xuanjihub/fpga-project-submission/05_PCB最终采纳/A01.2模块互连载板/reports/pin-map.csv

page | designator | pin | x | y | nc | net
01-FPGA-and-Power.esch2 | C1 | 1 | 760 | 480 | false | PWR_3V3
01-FPGA-and-Power.esch2 | C1 | 2 | 800 | 480 | false | GND
01-FPGA-and-Power.esch2 | C2 | 1 | 960 | 480 | false | PWR_3V3
01-FPGA-and-Power.esch2 | C2 | 2 | 1000 | 480 | false | GND
02-Touch-and-FSR.esch2 | C3 | 1 | 880 | 420 | false | PWR_3V3
02-Touch-and-FSR.esch2 | C3 | 2 | 920 | 420 | false | GND
03-Panel-and-OLED.esch2 | C4 | 1 | 780 | 355 | false | PWR_3V3
03-Panel-and-OLED.esch2 | C4 | 2 | 820 | 355 | false | GND
04-PCM-Audio.esch2 | C5 | 1 | 280 | 430 | false | PWR_5V
04-PCM-Audio.esch2 | C5 | 2 | 320 | 430 | false | GND
04-PCM-Audio.esch2 | C6 | 1 | 630 | 430 | false | PWR_5V
04-PCM-Audio.esch2 | C6 | 2 | 670 | 430 | false | GND
01-FPGA-and-Power.esch2 | J1 | 1 | 330 | 655 | true
01-FPGA-and-Power.esch2 | J1 | 2 | 390 | 655 | true
01-FPGA-and-Power.esch2 | J1 | 3 | 330 | 645 | false | SENS_SCL
01-FPGA-and-Power.esch2 | J1 | 4 | 390 | 645 | false | SENS_SDA
01-FPGA-and-Power.esch2 | J1 | 5 | 330 | 635 | false | PCM_BCK
01-FPGA-and-Power.esch2 | J1 | 6 | 390 | 635 | false | PCM_LRCK
01-FPGA-and-Power.esch2 | J1 | 7 | 330 | 625 | false | PCM_DIN
01-FPGA-and-Power.esch2 | J1 | 8 | 390 | 625 | true
01-FPGA-and-Power.esch2 | J1 | 9 | 330 | 615 | true
01-FPGA-and-Power.esch2 | J1 | 10 | 390 | 615 | true
01-FPGA-and-Power.esch2 | J1 | 11 | 330 | 605 | false | PWR_5V
01-FPGA-and-Power.esch2 | J1 | 12 | 390 | 605 | false | GND
01-FPGA-and-Power.esch2 | J1 | 13 | 330 | 595 | false | OLED_SCL
01-FPGA-and-Power.esch2 | J1 | 14 | 390 | 595 | false | OLED_SDA
01-FPGA-and-Power.esch2 | J1 | 15 | 330 | 585 | false | ENC0_A
01-FPGA-and-Power.esch2 | J1 | 16 | 390 | 585 | false | ENC0_B
01-FPGA-and-Power.esch2 | J1 | 17 | 330 | 575 | false | ENC1_A
01-FPGA-and-Power.esch2 | J1 | 18 | 390 | 575 | false | ENC1_B
01-FPGA-and-Power.esch2 | J1 | 19 | 330 | 565 | false | ENC2_A
01-FPGA-and-Power.esch2 | J1 | 20 | 390 | 565 | false | ENC2_B
01-FPGA-and-Power.esch2 | J1 | 21 | 330 | 555 | false | ENC3_A
01-FPGA-and-Power.esch2 | J1 | 22 | 390 | 555 | false | ENC3_B
01-FPGA-and-Power.esch2 | J1 | 23 | 330 | 545 | false | PANEL_K0
01-FPGA-and-Power.esch2 | J1 | 24 | 390 | 545 | false | PANEL_K1
01-FPGA-and-Power.esch2 | J1 | 25 | 330 | 535 | false | PANEL_K2
01-FPGA-and-Power.esch2 | J1 | 26 | 390 | 535 | false | PANEL_K3
01-FPGA-and-Power.esch2 | J1 | 27 | 330 | 525 | false | PANEL_K4
01-FPGA-and-Power.esch2 | J1 | 28 | 390 | 525 | false | PANEL_K5
01-FPGA-and-Power.esch2 | J1 | 29 | 330 | 515 | true
01-FPGA-and-Power.esch2 | J1 | 30 | 390 | 515 | true
01-FPGA-and-Power.esch2 | J1 | 31 | 330 | 505 | false | PANEL_K6
01-FPGA-and-Power.esch2 | J1 | 32 | 390 | 505 | false | PANEL_K7
01-FPGA-and-Power.esch2 | J1 | 33 | 330 | 495 | false | LASER_RX0
01-FPGA-and-Power.esch2 | J1 | 34 | 390 | 495 | false | LASER_RX1
01-FPGA-and-Power.esch2 | J1 | 35 | 330 | 485 | false | BLE_TX
01-FPGA-and-Power.esch2 | J1 | 36 | 390 | 485 | false | BLE_RX
01-FPGA-and-Power.esch2 | J1 | 37 | 330 | 475 | true
01-FPGA-and-Power.esch2 | J1 | 38 | 390 | 475 | true
01-FPGA-and-Power.esch2 | J1 | 39 | 330 | 465 | true
01-FPGA-and-Power.esch2 | J1 | 40 | 390 | 465 | true
01-FPGA-and-Power.esch2 | J2 | 1 | 830 | 655 | false | PWR_3V3
01-FPGA-and-Power.esch2 | J2 | 2 | 830 | 645 | false | GND
02-Touch-and-FSR.esch2 | J3 | 1 | 280 | 670 | false | GND
02-Touch-and-FSR.esch2 | J3 | 2 | 280 | 660 | false | SENS_SDA
02-Touch-and-FSR.esch2 | J3 | 3 | 280 | 650 | false | SENS_SCL
02-Touch-and-FSR.esch2 | J3 | 4 | 280 | 640 | true
02-Touch-and-FSR.esch2 | J3 | 5 | 280 | 630 | false | PWR_3V3
02-Touch-and-FSR.esch2 | J4 | 1 | 880 | 665 | false | PWR_3V3
02-Touch-and-FSR.esch2 | J4 | 2 | 880 | 655 | false | GND
02-Touch-and-FSR.esch2 | J4 | 3 | 880 | 645 | false | SENS_SCL
02-Touch-and-FSR.esch2 | J4 | 4 | 880 | 635 | false | SENS_SDA
02-Touch-and-FSR.esch2 | J4 | 5 | 880 | 625 | false | GND
02-Touch-and-FSR.esch2 | J4 | 6 | 880 | 615 | true
02-Touch-and-FSR.esch2 | J4 | 7 | 880 | 605 | false | GND
02-Touch-and-FSR.esch2 | J4 | 8 | 880 | 595 | false | FSR_A1
02-Touch-and-FSR.esch2 | J4 | 9 | 880 | 585 | true
02-Touch-and-FSR.esch2 | J4 | 10 | 880 | 575 | true
02-Touch-and-FSR.esch2 | J5 | 1 | 280 | 445 | false | PWR_3V3
02-Touch-and-FSR.esch2 | J5 | 2 | 280 | 435 | false | FSR_A1
03-Panel-and-OLED.esch2 | J6 | 1 | 260 | 670 | false | GND
03-Panel-and-OLED.esch2 | J6 | 2 | 260 | 660 | false | ENC0_A
03-Panel-and-OLED.esch2 | J6 | 3 | 260 | 650 | false | ENC0_B
03-Panel-and-OLED.esch2 | J6 | 4 | 260 | 640 | true
03-Panel-and-OLED.esch2 | J6 | 5 | 260 | 630 | false | PWR_3V3
03-Panel-and-OLED.esch2 | J7 | 1 | 620 | 670 | false | GND
03-Panel-and-OLED.esch2 | J7 | 2 | 620 | 660 | false | ENC1_A
03-Panel-and-OLED.esch2 | J7 | 3 | 620 | 650 | false | ENC1_B
03-Panel-and-OLED.esch2 | J7 | 4 | 620 | 640 | true
03-Panel-and-OLED.esch2 | J7 | 5 | 620 | 630 | false | PWR_3V3
03-Panel-and-OLED.esch2 | J8 | 1 | 260 | 470 | false | GND
03-Panel-and-OLED.esch2 | J8 | 2 | 260 | 460 | false | ENC2_A
03-Panel-and-OLED.esch2 | J8 | 3 | 260 | 450 | false | ENC2_B
03-Panel-and-OLED.esch2 | J8 | 4 | 260 | 440 | true
03-Panel-and-OLED.esch2 | J8 | 5 | 260 | 430 | false | PWR_3V3
03-Panel-and-OLED.esch2 | J9 | 1 | 620 | 470 | false | GND
03-Panel-and-OLED.esch2 | J9 | 2 | 620 | 460 | false | ENC3_A
03-Panel-and-OLED.esch2 | J9 | 3 | 620 | 450 | false | ENC3_B
03-Panel-and-OLED.esch2 | J9 | 4 | 620 | 440 | true
03-Panel-and-OLED.esch2 | J9 | 5 | 620 | 430 | false | PWR_3V3
03-Panel-and-OLED.esch2 | J10 | 1 | 1000 | 675 | false | PWR_3V3
03-Panel-and-OLED.esch2 | J10 | 2 | 1000 | 665 | false | GND
03-Panel-and-OLED.esch2 | J10 | 3 | 1000 | 655 | false | PANEL_K0
03-Panel-and-OLED.esch2 | J10 | 4 | 1000 | 645 | false | PANEL_K1
03-Panel-and-OLED.esch2 | J10 | 5 | 1000 | 635 | false | PANEL_K2
03-Panel-and-OLED.esch2 | J10 | 6 | 1000 | 625 | false | PANEL_K3
03-Panel-and-OLED.esch2 | J10 | 7 | 1000 | 615 | false | PANEL_K4
03-Panel-and-OLED.esch2 | J10 | 8 | 1000 | 605 | false | PANEL_K5
03-Panel-and-OLED.esch2 | J10 | 9 | 1000 | 595 | false | PANEL_K6
03-Panel-and-OLED.esch2 | J10 | 10 | 1000 | 585 | false | PANEL_K7
03-Panel-and-OLED.esch2 | J11 | 1 | 1000 | 455 | false | GND
03-Panel-and-OLED.esch2 | J11 | 2 | 1000 | 445 | false | PWR_3V3
03-Panel-and-OLED.esch2 | J11 | 3 | 1000 | 435 | false | OLED_SCL
03-Panel-and-OLED.esch2 | J11 | 4 | 1000 | 425 | false | OLED_SDA
04-PCM-Audio.esch2 | J12 | 1 | 280 | 675 | false | GND
04-PCM-Audio.esch2 | J12 | 2 | 280 | 665 | false | PCM_BCK
04-PCM-Audio.esch2 | J12 | 3 | 280 | 655 | false | PCM_DIN
04-PCM-Audio.esch2 | J12 | 4 | 280 | 645 | false | PCM_LRCK
04-PCM-Audio.esch2 | J12 | 5 | 280 | 635 | false | GND
04-PCM-Audio.esch2 | J12 | 6 | 280 | 625 | false | PWR_5V
04-PCM-Audio.esch2 | J13 | 1 | 880 | 680 | false | PCM_A3V3
04-PCM-Audio.esch2 | J13 | 2 | 880 | 670 | false | GND
04-PCM-Audio.esch2 | J13 | 3 | 880 | 660 | false | PCM_A3V3
04-PCM-Audio.esch2 | J13 | 4 | 880 | 650 | false | GND
04-PCM-Audio.esch2 | J13 | 5 | 880 | 640 | false | PCM_A3V3
04-PCM-Audio.esch2 | J13 | 6 | 880 | 630 | true
04-PCM-Audio.esch2 | J13 | 7 | 880 | 620 | true
04-PCM-Audio.esch2 | J13 | 8 | 880 | 610 | true
04-PCM-Audio.esch2 | J13 | 9 | 880 | 600 | true
05-Expansion-and-Notes.esch2 | J14 | 1 | 280 | 665 | false | PWR_3V3
05-Expansion-and-Notes.esch2 | J14 | 2 | 280 | 655 | false | GND
05-Expansion-and-Notes.esch2 | J14 | 3 | 280 | 645 | false | BLE_TX
05-Expansion-and-Notes.esch2 | J14 | 4 | 280 | 635 | false | BLE_RX
05-Expansion-and-Notes.esch2 | J15 | 1 | 830 | 665 | false | PWR_3V3
05-Expansion-and-Notes.esch2 | J15 | 2 | 830 | 655 | false | GND
05-Expansion-and-Notes.esch2 | J15 | 3 | 830 | 645 | false | LASER_RX0
05-Expansion-and-Notes.esch2 | J15 | 4 | 830 | 635 | false | LASER_RX1
02-Touch-and-FSR.esch2 | R1 | 1 | 550 | 440 | false | FSR_A1
02-Touch-and-FSR.esch2 | R1 | 2 | 590 | 440 | false | GND
