xuanjihub/fpga-project-submission/05_PCB最终采纳/A01.2模块互连载板/exports/pages/SCH_Carrier-A01_1-01-FPGA-and-Power_2026-10-15.png

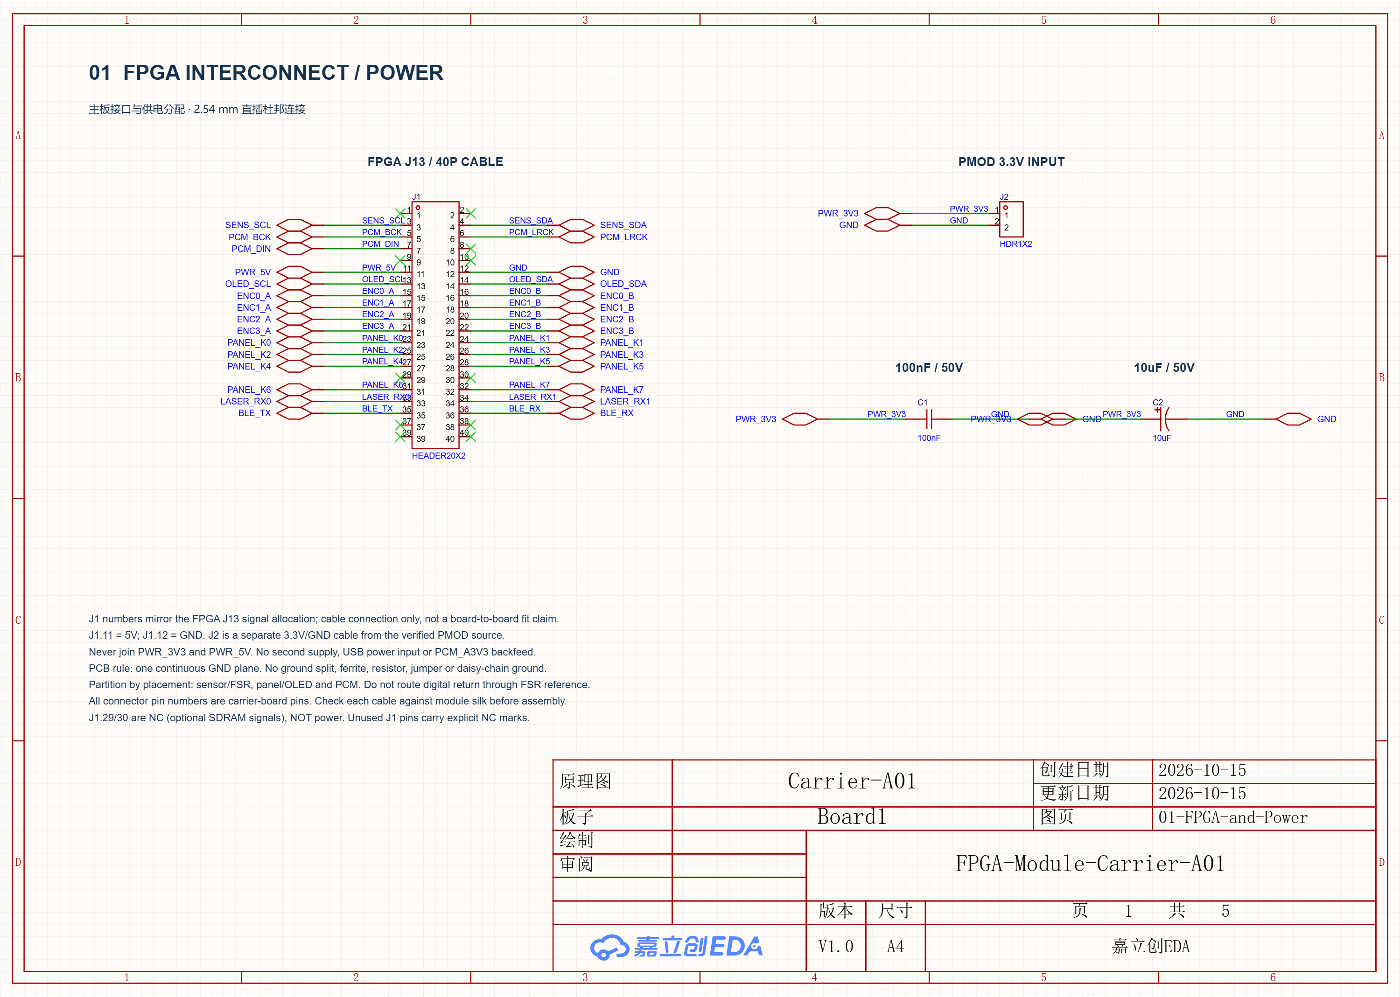
05_PCB最终采纳/A01.2模块互连载板/exports/pages/SCH_Carrier-A01_1-01-FPGA-and-Power_2026-10-15.png
