xuanjihub/fpga-project-submission/05_PCB最终采纳/A01.2模块互连载板/exports/pages/SCH_Carrier-A01_2-02-Touch-and-FSR_2026-10-15.png

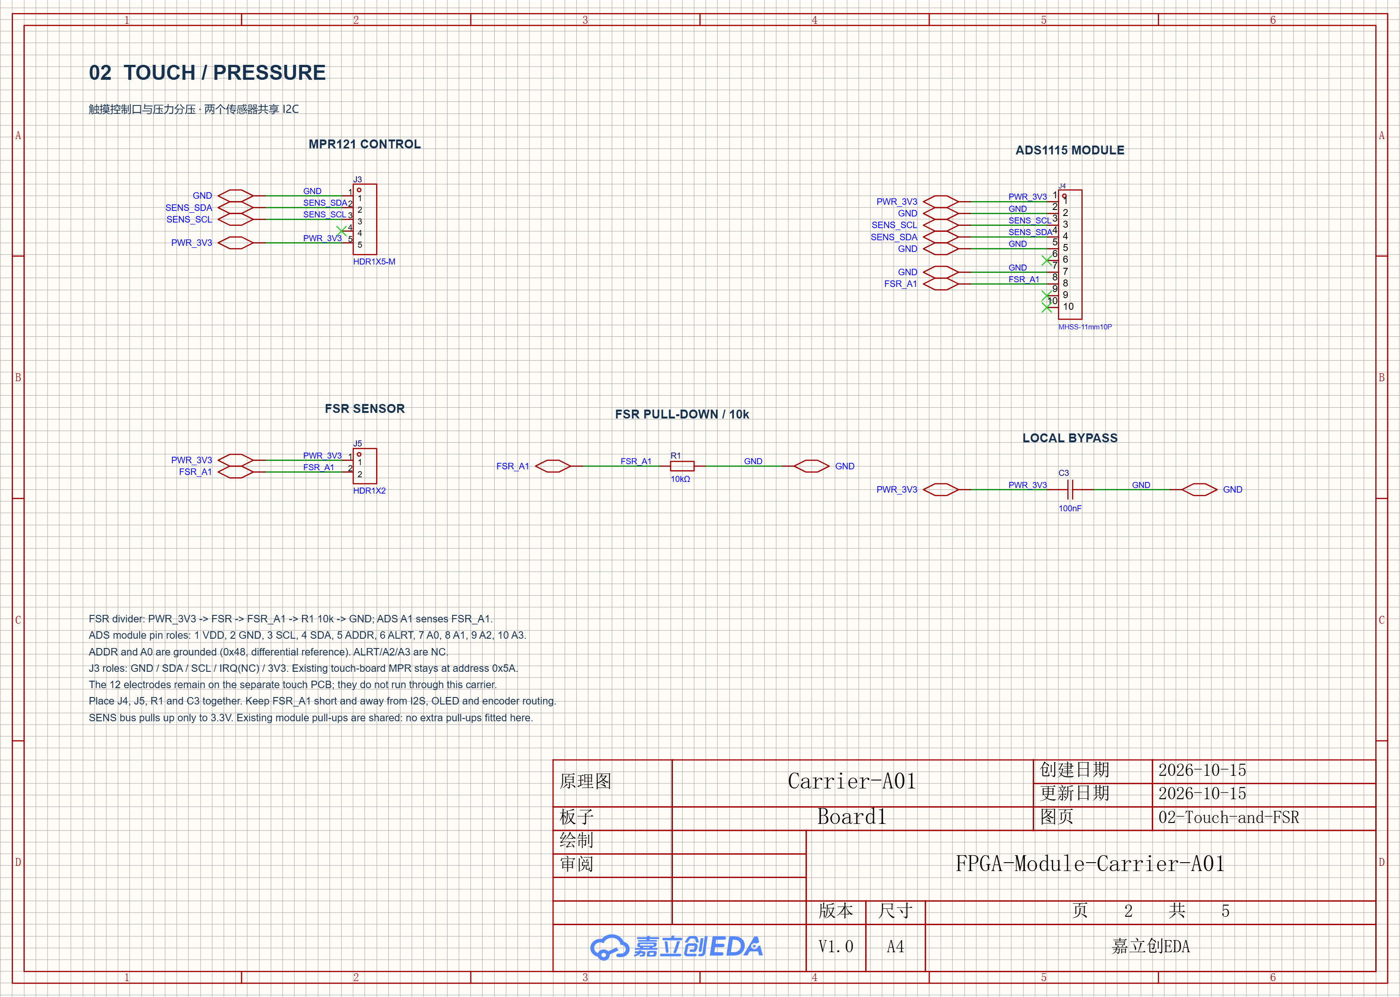
05_PCB最终采纳/A01.2模块互连载板/exports/pages/SCH_Carrier-A01_2-02-Touch-and-FSR_2026-10-15.png
