xuanjihub/fpga-project-submission/05_PCB最终采纳/A01.2模块互连载板/exports/pages/SCH_Carrier-A01_4-04-PCM-Audio_2026-10-15.png

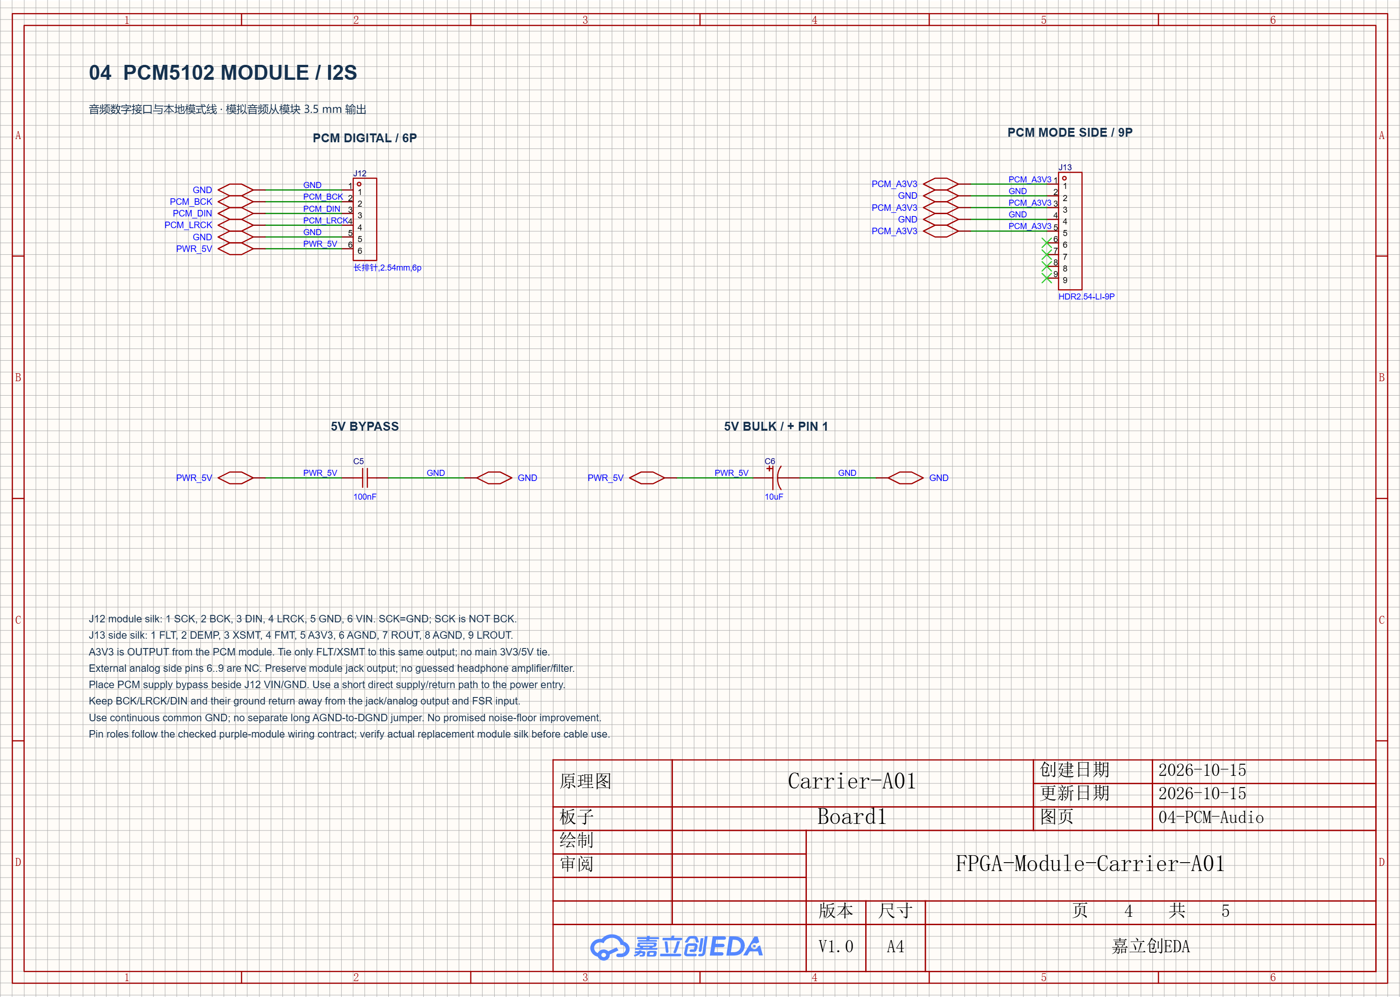
05_PCB最终采纳/A01.2模块互连载板/exports/pages/SCH_Carrier-A01_4-04-PCM-Audio_2026-10-15.png
