xuanjihub/fpga-project-submission/05_PCB最终采纳/A01.2模块互连载板/exports/pages/SCH_Carrier-A01_5-05-Expansion-and-Notes_2026-10-15.png

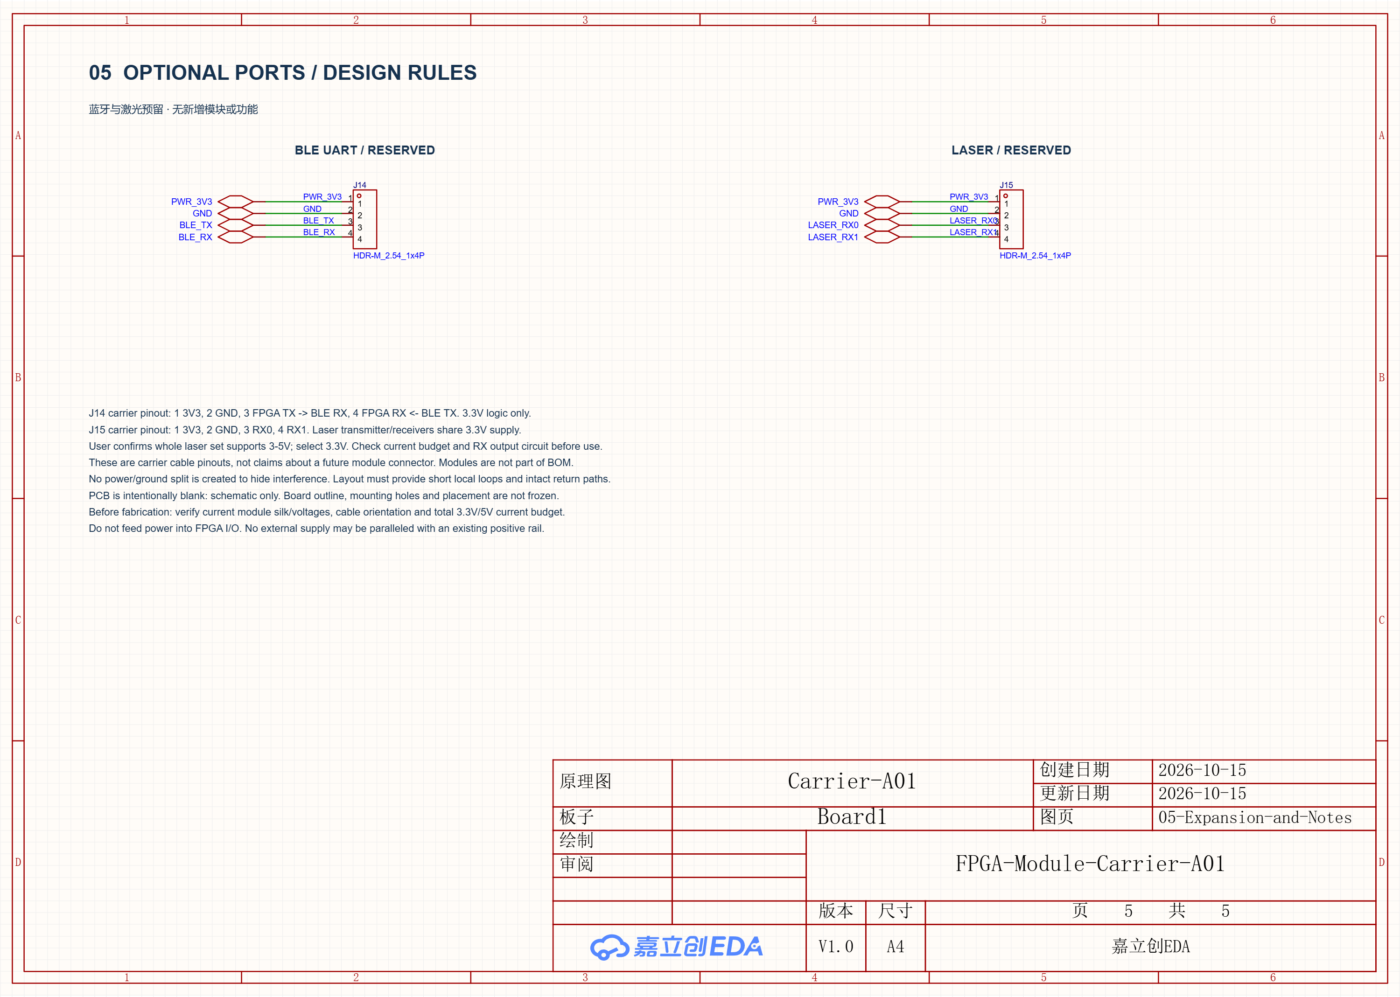
05_PCB最终采纳/A01.2模块互连载板/exports/pages/SCH_Carrier-A01_5-05-Expansion-and-Notes_2026-10-15.png
