xuanjihub/fpga-project-submission/05_PCB最终采纳/A01.2模块互连载板/exports/pcb-layout-preview.png

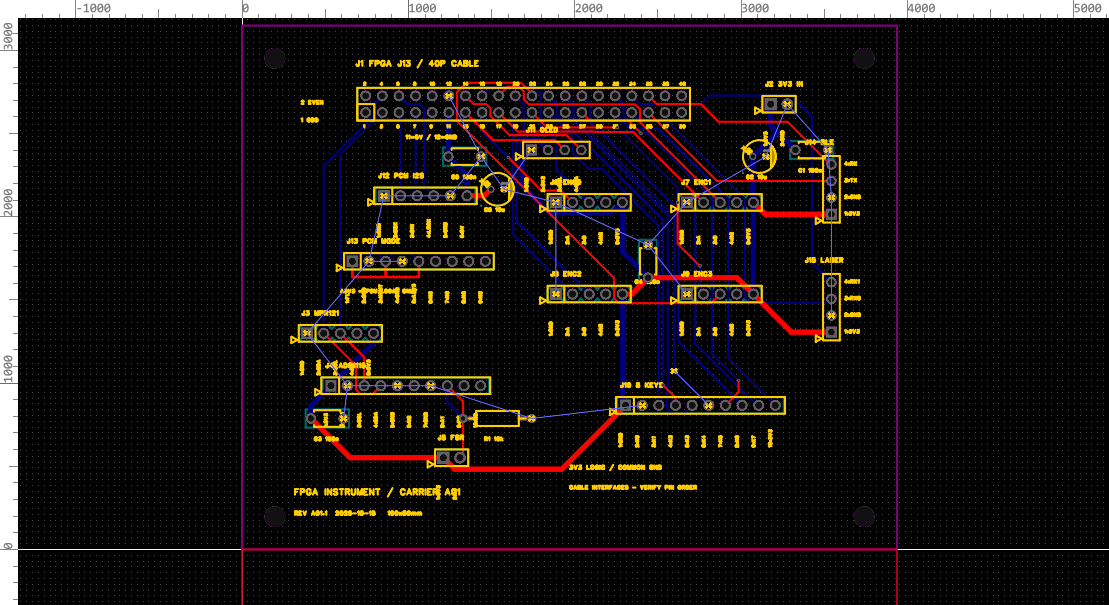
05_PCB最终采纳/A01.2模块互连载板/exports/pcb-layout-preview.png
