xuanjihub/fpga-project-submission/05_PCB最终采纳/A01.2模块互连载板/reports/library-manifest.csv

page | designator | name | device_uuid | device_title | symbol_uuid | footprint_uuid | footprint_name | library_uuid | manufacturer | manufacturer_part | supplier_part | value | voltage | temperature_coefficient | pads
01-FPGA-and-Power.esch2 | C1 | 100nF | 5acfbbd8188c43b1 | FG28X7R1H104KNT06_C342794 | dc1b6fe9b64409b0 | a5b3463529883940 | CAP-TH_L4.0-W2.5-P5.00-D1.0 | 0819f05c4eef4c71ace90d822a990e87 | TDK | FG28X7R1H104KNT06 | C342794 | 100nF | 50V | X7R | 1;2
01-FPGA-and-Power.esch2 | C2 | 10uF | 58f4f13bf713cad2 | 50ZLH10MEFC5X11 | b02e2909af2d5bb6 | 87ba9ff13780c434 | CAP-TH_BD5.0-P2.00-D0.5-FD | 0819f05c4eef4c71ace90d822a990e87 | rubycon(红宝石) | 50ZLH10MEFC5X11 | C1591331 | 10uF | 50V |  | 1;2
02-Touch-and-FSR.esch2 | C3 | 100nF | 5acfbbd8188c43b1 | FG28X7R1H104KNT06_C342794 | dc1b6fe9b64409b0 | a5b3463529883940 | CAP-TH_L4.0-W2.5-P5.00-D1.0 | 0819f05c4eef4c71ace90d822a990e87 | TDK | FG28X7R1H104KNT06 | C342794 | 100nF | 50V | X7R | 1;2
03-Panel-and-OLED.esch2 | C4 | 100nF | 5acfbbd8188c43b1 | FG28X7R1H104KNT06_C342794 | dc1b6fe9b64409b0 | a5b3463529883940 | CAP-TH_L4.0-W2.5-P5.00-D1.0 | 0819f05c4eef4c71ace90d822a990e87 | TDK | FG28X7R1H104KNT06 | C342794 | 100nF | 50V | X7R | 1;2
04-PCM-Audio.esch2 | C5 | 100nF | 5acfbbd8188c43b1 | FG28X7R1H104KNT06_C342794 | dc1b6fe9b64409b0 | a5b3463529883940 | CAP-TH_L4.0-W2.5-P5.00-D1.0 | 0819f05c4eef4c71ace90d822a990e87 | TDK | FG28X7R1H104KNT06 | C342794 | 100nF | 50V | X7R | 1;2
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
02-Touch-and-FSR.esch2 | R1 | 10kΩ | baa1913c0ab3bb9a | MF1/4W-10KΩ±1% T | 330217927cb24891 | ed7d17667611544f | RES-TH_BD2.3-L6.5-P10.50-D0.5 | 0819f05c4eef4c71ace90d822a990e87 | CCO(千志电子) | MF1/4W-10KΩ±1% T | C119347 | 10kΩ |  | ±100ppm/℃ | 1;2
