xuanjihub/fpga-project-submission/04_Blender最终模型/SB20-Bambu-3plates.3mf

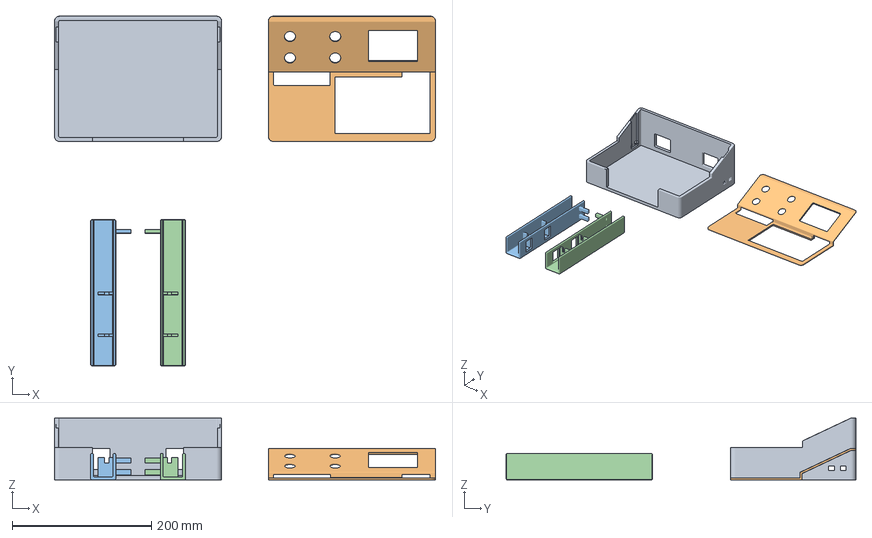
[picture p9: CAD file, 2026-11-03]
04_Blender最终模型/SB20-Bambu-3plates.3mf
547.2 x 502.2 x 88.7 mm
01-lower-tub.stl
02-upper-cover.stl
03-laser-L.stl
04-laser-R.stl
