xuanjihub/fpga-project-submission/04_Blender最终模型/最终四件STL与几何记录/04-laser-R.stl

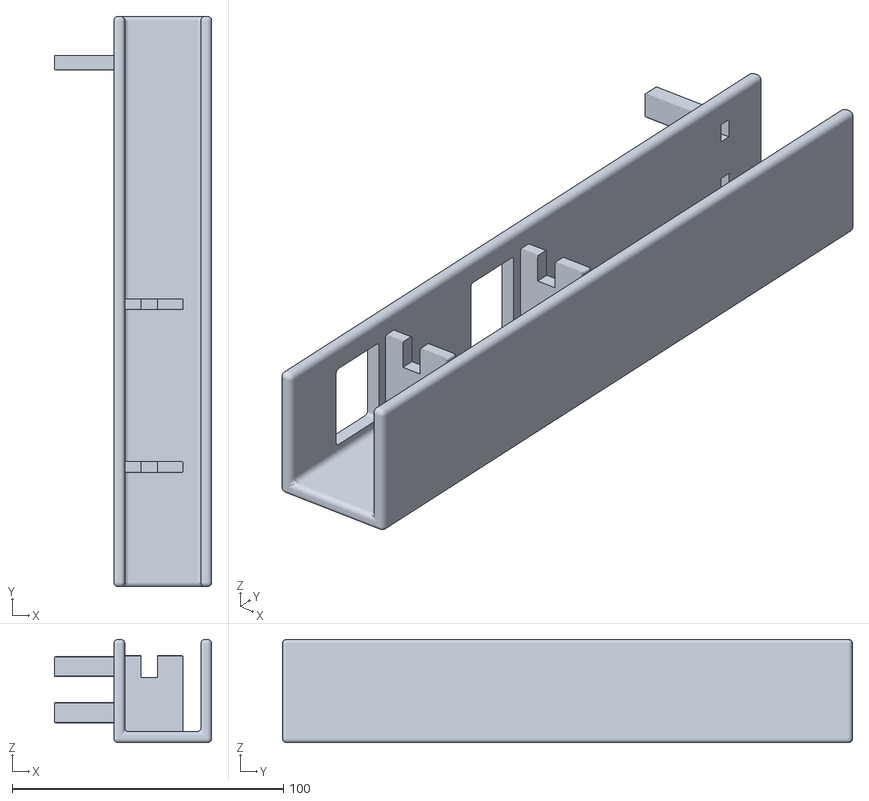
[picture p10: CAD file, 2026-11-03]
04_Blender最终模型/最终四件STL与几何记录/04-laser-R.stl
58.0 x 210.0 x 38.0
