xuanjihub/fpga-project-submission/05_PCB最终采纳/A01.2模块互连载板/exports/manufacturing/Carrier-A01-outline.dxf

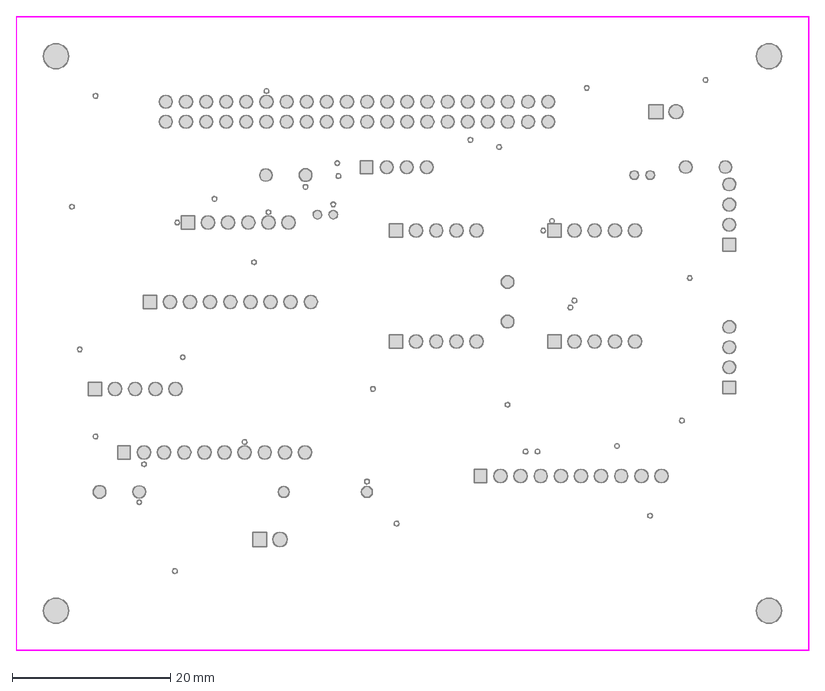
[picture p11: CAD file, 2026-11-03]
05_PCB最终采纳/A01.2模块互连载板/exports/manufacturing/Carrier-A01-outline.dxf
100.1 x 80.1 mm
