xuanjihub/fpga-project-submission/04_Blender最终模型/最终四件STL与几何记录/01-lower-tub.stl

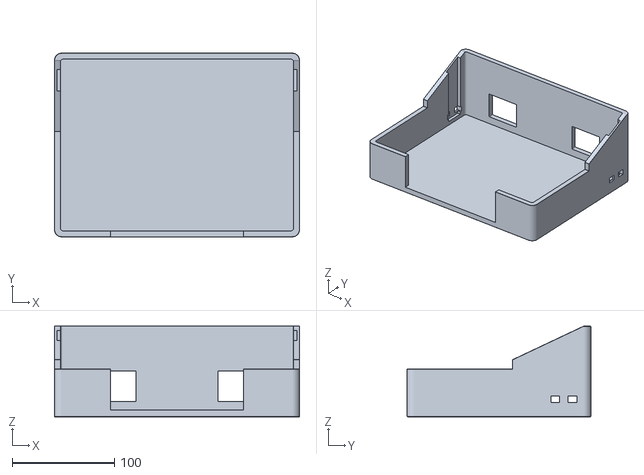
[picture p12: CAD file, 2026-11-03]
04_Blender最终模型/最终四件STL与几何记录/01-lower-tub.stl
240.0 x 180.0 x 88.7
