xuanjihub/fpga-project-submission/04_Blender最终模型/最终四件STL与几何记录/02-upper-cover.stl

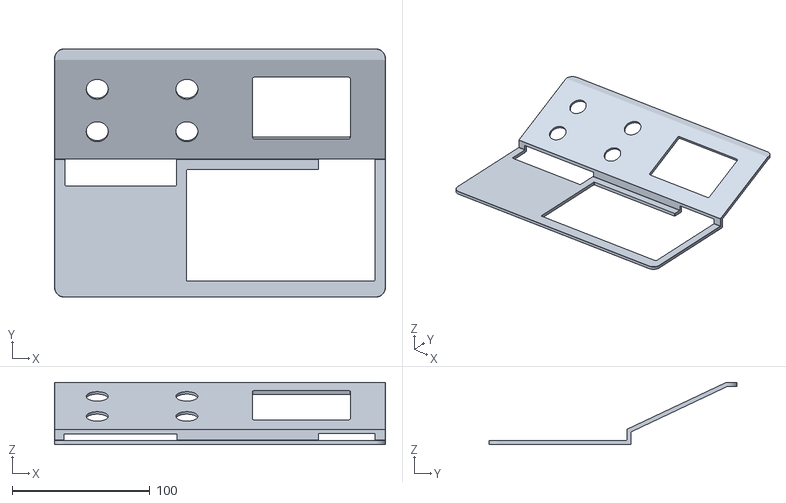
[picture p13: CAD file, 2026-11-03]
04_Blender最终模型/最终四件STL与几何记录/02-upper-cover.stl
240.0 x 180.0 x 45.0
