xuanjihub/fpga-project-submission/(list of files, cad)

Other CAD files:
04_Blender最终模型/最终四件STL与几何记录/03-laser-L.stl
04_Blender最终模型/SB20.blend
