xuanjihub/fpga-project-submission/(list of files, drawings)

Other design files:
05_PCB最终采纳/A01.2模块互连载板/reports/pcb-final-snapshot.json
05_PCB最终采纳/A01.2模块互连载板/reports/pcb-reopened-snapshot.json
