xuanjihub/fpga-project-submission/FPGA_ESP32_APP_源码精简版_20261104_024723/FPGA/outputs/audio_timbres_v1/src/timbre_wave_rom_v1.v

// Generated waveform ROM data.
// ID0 SINE / ID1 PULSE: frozen 512 S13 words are bit exact.
// ID2 ORGAN / ID3 REED: finite-harmonic mathematical style candidates.
// 256 phase samples each; new pages peak=32700 and exact integer DC=0.
// ORGAN retains even harmonics: phase-axis odd symmetry.
// REED additionally has half-wave antisymmetry.
// At notes60..71 plus <=2-semitone bend all designed harmonics are
// below nominal Nyquist. All 128 note inputs remain accepted unchanged;
// sufficiently high notes can alias.
// One synchronous read edge and original asynchronous reset semantics.
module timbre_wave_rom_v1(input wire clk,rst_n,input wire [9:0] addr,output reg [15:0] data);
 always @(posedge clk or negedge rst_n)
  if(!rst_n)data<=0;
  else case(addr)
   10'd0: data<=16'd0;
   10'd1: data<=16'd804;
   10'd2: data<=16'd1607;
   10'd3: data<=16'd2410;
   10'd4: data<=16'd3211;
   10'd5: data<=16'd4011;
   10'd6: data<=16'd4807;
   10'd7: data<=16'd5601;
   10'd8: data<=16'd6392;
   10'd9: data<=16'd7179;
   10'd10: data<=16'd7961;
   10'd11: data<=16'd8739;
   10'd12: data<=16'd9511;
   10'd13: data<=16'd10278;
   10'd14: data<=16'd11039;
   10'd15: data<=16'd11792;
   10'd16: data<=16'd12539;
   10'd17: data<=16'd13278;
   10'd18: data<=16'd14009;
   10'd19: data<=16'd14732;
   10'd20: data<=16'd15446;
   10'd21: data<=16'd16151;
   10'd22: data<=16'd16845;
   10'd23: data<=16'd17530;
   10'd24: data<=16'd18204;
   10'd25: data<=16'd18867;
   10'd26: data<=16'd19519;
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
   10'd999: data<=16'd42156;
   10'd1000: data<=16'd41335;
   10'd1001: data<=16'd40419;
   10'd1002: data<=16'd39424;
   10'd1003: data<=16'd38376;
   10'd1004: data<=16'd37306;
   10'd1005: data<=16'd36253;
   10'd1006: data<=16'd35260;
   10'd1007: data<=16'd34372;
   10'd1008: data<=16'd33640;
   10'd1009: data<=16'd33112;
   10'd1010: data<=16'd32836;
   10'd1011: data<=16'd32856;
   10'd1012: data<=16'd33212;
   10'd1013: data<=16'd33936;
   10'd1014: data<=16'd35052;
   10'd1015: data<=16'd36574;
   10'd1016: data<=16'd38505;
   10'd1017: data<=16'd40838;
   10'd1018: data<=16'd43554;
   10'd1019: data<=16'd46623;
   10'd1020: data<=16'd50004;
   10'd1021: data<=16'd53646;
   10'd1022: data<=16'd57493;
   10'd1023: data<=16'd61479;
   default: data<=0;
  endcase
endmodule
