xuanjihub/fpga-project-submission/FPGA_ESP32_APP_源码精简版_20261104_024723/FPGA/outputs/miseki_panel_v1/src/miseki_font_v1.v

`timescale 1ns/1ps
// Font bitmap data: bounded Miseki CJK subset, SIL OFL 1.1; see ../font/OFL.txt.
// CJK source SHA256 f87164d114c98c5abd420bd0048c17710c5362d8a5478686005cd73e155d80e8
// Latin: existing project 5x7, centered in 8px cells. bit0 is top.
module miseki_font_v1(input wire [7:0] codepoint,input wire [2:0] column,output wire [7:0] data);
    reg [63:0] glyph;
    always @* begin case(codepoint)
        8'h20:glyph=64'h0000000000000000; // SPACE
        8'h21:glyph=64'h0000005f00000000; // !
        8'h25:glyph=64'h0023130864620000; // %
        8'h2a:glyph=64'h0014083e08140000; // *
        8'h2b:glyph=64'h0008083e08080000; // +
        8'h2d:glyph=64'h0008080808080000; // -
        8'h2e:glyph=64'h0000606000000000; // .
        8'h2f:glyph=64'h0020100804020000; // /
        8'h30:glyph=64'h003e5149453e0000; // 0
        8'h31:glyph=64'h0000427f40000000; // 1
        8'h32:glyph=64'h0042615149460000; // 2
        8'h33:glyph=64'h002141454b310000; // 3
        8'h34:glyph=64'h001814127f100000; // 4
        8'h35:glyph=64'h0027454545390000; // 5
        8'h36:glyph=64'h003c4a4949300000; // 6
        8'h37:glyph=64'h0001710905030000; // 7
        8'h38:glyph=64'h0036494949360000; // 8
        8'h39:glyph=64'h00064949291e0000; // 9
        8'h3a:glyph=64'h0000363600000000; // :
        8'h3c:glyph=64'h0008142241000000; // <
        8'h3d:glyph=64'h0014141414140000; // =
        8'h3e:glyph=64'h0000412214080000; // >
        8'h3f:glyph=64'h0002015109060000; // ?
        8'h41:glyph=64'h007e1111117e0000; // A
        8'h42:glyph=64'h007f494949360000; // B
        8'h43:glyph=64'h003e414141220000; // C
        8'h44:glyph=64'h007f4141221c0000; // D
        8'h45:glyph=64'h007f494949410000; // E
        8'h46:glyph=64'h007f090909010000; // F
        8'h47:glyph=64'h003e4141497a0000; // G
        8'h48:glyph=64'h007f0808087f0000; // H
        8'h49:glyph=64'h0000417f41000000; // I
        8'h4a:glyph=64'h002040413f010000; // J
        8'h4b:glyph=64'h007f081422410000; // K
        8'h4c:glyph=64'h007f404040400000; // L
        8'h4d:glyph=64'h007f020c027f0000; // M
        8'h4e:glyph=64'h007f0408107f0000; // N
        8'h4f:glyph=64'h003e4141413e0000; // O
        8'h50:glyph=64'h007f090909060000; // P
        8'h51:glyph=64'h003e4151215e0000; // Q
        8'h52:glyph=64'h007f091929460000; // R
        8'h53:glyph=64'h0046494949310000; // S
        8'h54:glyph=64'h0001017f01010000; // T
        8'h55:glyph=64'h003f4040403f0000; // U
        8'h56:glyph=64'h001f2040201f0000; // V
        8'h57:glyph=64'h003f4038403f0000; // W
        8'h58:glyph=64'h0063140814630000; // X
        8'h59:glyph=64'h0007087008070000; // Y
        8'h5a:glyph=64'h0061514945430000; // Z
        8'h7e:glyph=64'h0008040810080000; // ~
        8'h80:glyph=64'h202f2a2a4a7a0200; // 与
        8'h81:glyph=64'h0404027d02040400; // 个
        8'h82:glyph=64'h1e12127f12121e00; // 中
        8'h83:glyph=64'h40251c0714447c00; // 为
        8'h84:glyph=64'h047e01404d314f00; // 仅
        8'h85:glyph=64'h047e015823584600; // 仪
        8'h86:glyph=64'h047e015f48225f00; // 似
        8'h87:glyph=64'h047e435a635e4200; // 位
        8'h88:glyph=64'h047e017e6a3e4900; // 低
        8'h89:glyph=64'h047e01047f2a2a00; // 作
        8'h8a:glyph=64'h047e535e3f4a4e00; // 使
        8'h8b:glyph=64'h047e51377d375000; // 保
        8'h8c:glyph=64'h047e3f545d375400; // 候
        8'h8d:glyph=64'h047e437a6f7a4200; // 值
        8'h8e:glyph=64'h047e553b567f5600; // 健
        8'h8f:glyph=64'h4c4b3a0f7a4a6800; // 先
        8'h90:glyph=64'h484a380f784a6800; // 光
        8'h91:glyph=64'h4020190618204000; // 入
        8'h92:glyph=64'h484a2b1e2b4a4800; // 关
        8'h93:glyph=64'h7e120a070a527e00; // 内
        8'h94:glyph=64'h117f151f557f1100; // 再
        8'h95:glyph=64'h71001e127f121e00; // 冲
        8'h96:glyph=64'h7100047f4a7f4a00; // 准
        8'h97:glyph=64'h71403e6a6a3f5200; // 减
        8'h98:glyph=64'h704e487f484e7000; // 出
        8'h99:glyph=64'h495d3b2d0e407f00; // 到
        8'h9a:glyph=64'h642b7f2a6e007f00; // 制
        8'h9b:glyph=64'h7a2b7a021a437a00; // 前
        8'h9c:glyph=64'h42221a0702427e00; // 力
        8'h9d:glyph=64'h223e12423f427e00; // 功
        8'h9e:glyph=64'h423f427e7e427e00; // 加
        8'h9f:glyph=64'h04037e565e425e00; // 包
        8'ha0:glyph=64'h7f555f207f011f00; // 即
        8'ha1:glyph=64'h403f41497f496100; // 压
        8'ha2:glyph=64'h403f214d7f0d2100; // 原
        8'ha3:glyph=64'h144e574e250e1400; // 参
        8'ha4:glyph=64'h213f2d7f2a122e00; // 取
        8'ha5:glyph=64'h4d475d2f5d474d00; // 受
        8'ha6:glyph=64'h4a425e2b5e424a00; // 变
        8'ha7:glyph=64'h04041f5557740400; // 号
        8'ha8:glyph=64'h0474525556740400; // 合
        8'ha9:glyph=64'h403e0a6a69690800; // 后
        8'haa:glyph=64'h403e0a7b5a5e7000; // 启
        8'hab:glyph=64'h286b6b1c6b6f2800; // 器
        8'hac:glyph=64'h7f514f414f497f00; // 四
        8'had:glyph=64'h7f415d555d417f00; // 回
        8'hae:glyph=64'h7f41756f75417f00; // 固
        8'haf:glyph=64'h127a474a7e4a4200; // 在
        8'hb0:glyph=64'h423a2a3f2a3a0200; // 声
        8'hb1:glyph=64'h087a5a755b780800; // 备
        8'hb2:glyph=64'h44535e2e5e424200; // 复
        8'hb3:glyph=64'h50555a301f505000; // 头
        8'hb4:glyph=64'h281a4e3f4e1a2800; // 奏
        8'hb5:glyph=64'h445c372c6c6b6c00; // 始
        8'hb6:glyph=64'h127a1752761e1200; // 存
        8'hb7:glyph=64'h5652361776525600; // 完
        8'hb8:glyph=64'h4632467f56524600; // 定
        8'hb9:glyph=64'h147f103a557b1000; // 将
        8'hba:glyph=64'h224e7b2e443f4500; // 就
        8'hbb:glyph=64'h403f2b2b7f575300; // 尾
        8'hbc:glyph=64'h3d494949494f6000; // 已
        8'hbd:glyph=64'h1115117f19151100; // 平
        8'hbe:glyph=64'h403e1256771e3200; // 序
        8'hbf:glyph=64'h403e526253625a00; // 应
        8'hc0:glyph=64'h403e4a5e2b5e4a00; // 度
        8'hc1:glyph=64'h403e5a2a7f2e5600; // 康
        8'hc2:glyph=64'h553b405a525e5500; // 延
        8'hc3:glyph=64'h08493f097f090800; // 开
        8'hc4:glyph=64'h424a3a2a0f324300; // 式
        8'hc5:glyph=64'h5d774a6e5b264200; // 弦
        8'hc6:glyph=64'h5d77405b7f5b6000; // 强
        8'hc7:glyph=64'h0045565754567d00; // 当
        8'hc8:glyph=64'h5425557d25574400; // 录
        8'hc9:glyph=64'h0a7d286a2f7a2800; // 待
        8'hca:glyph=64'h067f484a3f4e4800; // 快
        8'hcb:glyph=64'h6a2a4653660a6a00; // 态
        8'hcc:glyph=64'h602e4b5a6b0e6000; // 总
        8'hcd:glyph=64'h067f0a57423a5200; // 恢
        8'hce:glyph=64'h68264e4e62076a00; // 感
        8'hcf:glyph=64'h067f4c5f2d5f4c00; // 慢
        8'hd0:glyph=64'h403e4a3a423f5200; // 成
        8'hd1:glyph=64'h527f235e2b5a4300; // 拨
        8'hd2:glyph=64'h527f286a2f7a2800; // 持
        8'hd3:glyph=64'h527f455457547d00; // 挡
        8'hd4:glyph=64'h527f5b3579355b00; // 探
        8'hd5:glyph=64'h527f4a5e2b3e4a00; // 接
        8'hd6:glyph=64'h527f465673564600; // 控
        8'hd7:glyph=64'h527f525f365f5200; // 摸
        8'hd8:glyph=64'h527f0a77723f5e00; // 撤
        8'hd9:glyph=64'h527f5c377d375c00; // 操
        8'hda:glyph=64'h3e207f445f225e00; // 收
        8'hdb:glyph=64'h423e4b7a5c235e00; // 放
        8'hdc:glyph=64'h3a2f3a445f225e00; // 故
        8'hdd:glyph=64'h4a5623565c235e00; // 效
        8'hde:glyph=64'h557a57325d235e00; // 数
        8'hdf:glyph=64'h42422e132e424200; // 文
        8'he0:glyph=64'h52167b165e0a7900; // 新
        8'he1:glyph=64'h5a4a3e2b2a6e1a00; // 旁
        8'he2:glyph=64'h4849291f79496800; // 无
        8'he3:glyph=64'h7f555f4d2b794f00; // 既
        8'he4:glyph=64'h3e2a3e0a527f0200; // 时
        8'he5:glyph=64'h48577d457d574800; // 显
        8'he6:glyph=64'h120a7f2a2a7a0200; // 有
        8'he7:glyph=64'h1a7f215f51275c00; // 极
        8'he8:glyph=64'h505f357f355f5000; // 果
        8'he9:glyph=64'h1a7f34457d053400; // 标
        8'hea:glyph=64'h1a7f222b7e2b2200; // 样
        8'heb:glyph=64'h1a7f1a7f5a7f1a00; // 槽
        8'hec:glyph=64'h1a7f525f365f5200; // 模
        8'hed:glyph=64'h4179417f49494100; // 正
        8'hee:glyph=64'h7c403f247f486400; // 此
        8'hef:glyph=64'h7500486a5f2a4800; // 法
        8'hf0:glyph=64'h75005f3d5f0e7f00; // 测
        8'hf1:glyph=64'h75007d1417547d00; // 消
        8'hf2:glyph=64'h75005b3579355b00; // 深
        8'hf3:glyph=64'h75007f55057d5700; // 混
        8'hf4:glyph=64'h7500562a3b2a5600; // 演
        8'hf5:glyph=64'h75482e5f7c235e00; // 激
        8'hf6:glyph=64'h147f44241f244500; // 状
        8'hf7:glyph=64'h22363a772a362200; // 率
        8'hf8:glyph=64'h15172d286d171500; // 琴
        8'hf9:glyph=64'h4453527f52524200; // 生
        8'hfa:glyph=64'h403f157f15557f00; // 用
        8'hfb:glyph=64'h001e1a3f5a5e6000; // 电
        8'hfc:glyph=64'h0e7a597459770f00; // 留
        8'hfd:glyph=64'h4a7b5a7e5a7b4a00; // 盖
        8'hfe:glyph=64'h007f555555557f00; // 目
        8'hff:glyph=64'h0937313e7d177c00; // 确
        8'h01:glyph=64'h2415457d05152400; // 示
        8'h02:glyph=64'h357f08465f221400; // 秒
        8'h03:glyph=64'h357f245b7e0a3600; // 称
        8'h04:glyph=64'h357f157d14577d00; // 稍
        8'h05:glyph=64'h464a5673564a4600; // 空
        8'h06:glyph=64'h1413365c7b161200; // 等
        8'h07:glyph=64'h1c0b7e7c6b6e1a00; // 管
        8'h08:glyph=64'h4c7b2e3c2b7e4a00; // 簧
        8'h09:glyph=64'h50155f7513095000; // 系
        8'h0a:glyph=64'h5a55087a557b0800; // 络
        8'h0b:glyph=64'h5a554a3e0b764a00; // 统
        8'h0c:glyph=64'h5a55281a6f6a6900; // 绪
        8'h0d:glyph=64'h5a55145d371d5c00; // 续
        8'h0e:glyph=64'h477d5755577d4700; // 置
        8'h0f:glyph=64'h047e2d7e007f5a00; // 能
        8'h10:glyph=64'h7f157f285d7d2800; // 脉
        8'h11:glyph=64'h023e555d575c6000; // 色
        8'h12:glyph=64'h0a7d0405457d0400; // 行
        8'h13:glyph=64'h2a2a7e573e4a4a00; // 衰
        8'h14:glyph=64'h297745572d5f4100; // 覆
        8'h15:glyph=64'h423d7f4a7f4a6e00; // 触
        8'h16:glyph=64'h02626a6b6a620200; // 言
        8'h17:glyph=64'h047d2040201f6000; // 认
        8'h18:glyph=64'h047d445b295f4400; // 设
        8'h19:glyph=64'h047d5474573c4500; // 试
        8'h1a:glyph=64'h047d147d577d1000; // 语
        8'h1b:glyph=64'h047d2054573d5700; // 误
        8'h1c:glyph=64'h047d287a2f7a0800; // 请
        8'h1d:glyph=64'h053c7f352f357f00; // 调
        8'h1e:glyph=64'h4a3a3f4a5d555700; // 起
        8'h1f:glyph=64'h777d57087a557b00; // 路
        8'h22:glyph=64'h382a7f2a4f385a00; // 载
        8'h23:glyph=64'h2e7b4a5623564a00; // 较
        8'h24:glyph=64'h2e7b2a7275067400; // 输
        8'h26:glyph=64'h4938545d554d5400; // 运
        8'h27:glyph=64'h493a605e4a794800; // 近
        8'h28:glyph=64'h493a605e6e556d00; // 返
        8'h29:glyph=64'h49386a5f4a7f4a00; // 进
        8'h2c:glyph=64'h493a504f454d5700; // 迟
        8'h3b:glyph=64'h49386c5b4f7a6800; // 选
        8'h40:glyph=64'h493a69577d495500; // 逐
        8'h5b:glyph=64'h49386e4a6f4e6a00; // 遮
        8'h5c:glyph=64'h0a7e5b7e7f251b00; // 部
        8'h5d:glyph=64'h7d6f7d0079496f00; // 配
        8'h5e:glyph=64'h5256327639555100; // 采
        8'h5f:glyph=64'h55317f292b752b00; // 释
        8'h60:glyph=64'h445f557d555f4400; // 量
        8'h61:glyph=64'h167d547d14577d00; // 销
        8'h62:glyph=64'h167d4a7f5a7f0a00; // 错
        8'h63:glyph=64'h7d4029597d097f00; // 闭
        8'h64:glyph=64'h7d28197d19297f00; // 闲
        8'h65:glyph=64'h7d007d557d017f00; // 间
        8'h66:glyph=64'h7f1b2a3e7b3e2a00; // 障
        8'h67:glyph=64'h662a6f3f6b2e6600; // 需
        8'h68:glyph=64'h087a2f7a2a7d3b00; // 静
        8'h69:glyph=64'h087a5e5b5e7a0800; // 音
        8'h6a:glyph=64'h223e125d37055d00; // 项
        8'h6b:glyph=64'h497d1b405d375d00; // 预
        8'h6c:glyph=64'h5e483f1a5d375d00; // 频
        8'h6d:glyph=64'h4e7e7b2e5d375d00; // 颤
        8'h6e:glyph=64'h403f1509157f4000; // 风
        8'h6f:glyph=64'h72127e5b7e127200; // 高
        default:glyph=64'h007f4141417f0000;
    endcase end
    assign data=glyph[63-column*8 -: 8];
endmodule
