xuanjihub/fpga-project-submission/FPGA_ESP32_APP_源码精简版_20261104_024723/FPGA/outputs/mega138k_s09_touch_pcm_v1/src/note_to_step.v

// Generated for nominal Fs=50,000,000/1024=48,828.125 Hz, A4=440 Hz.
// round(440 * 2**((note-69)/12) * 2**32 / Fs). One-period DDS only.
module note_to_step(input wire [6:0] note, output reg [31:0] step);
always @* case(note)
7'd0: step=32'd719151;
7'd1: step=32'd761914;
7'd2: step=32'd807220;
7'd3: step=32'd855219;
7'd4: step=32'd906073;
7'd5: step=32'd959951;
7'd6: step=32'd1017033;
7'd7: step=32'd1077509;
7'd8: step=32'd1141581;
7'd9: step=32'd1209463;
7'd10: step=32'd1281381;
7'd11: step=32'd1357576;
7'd12: step=32'd1438302;
7'd13: step=32'd1523828;
7'd14: step=32'd1614439;
7'd15: step=32'd1710439;
7'd16: step=32'd1812147;
7'd17: step=32'd1919903;
7'd18: step=32'd2034066;
7'd19: step=32'd2155018;
7'd20: step=32'd2283162;
7'd21: step=32'd2418926;
7'd22: step=32'd2562762;
7'd23: step=32'd2715152;
7'd24: step=32'd2876604;
7'd25: step=32'd3047655;
7'd26: step=32'd3228878;
7'd27: step=32'd3420877;
7'd28: step=32'd3624293;
7'd29: step=32'd3839805;
7'd30: step=32'd4068132;
7'd31: step=32'd4310035;
7'd32: step=32'd4566323;
7'd33: step=32'd4837851;
7'd34: step=32'd5125525;
7'd35: step=32'd5430304;
7'd36: step=32'd5753207;
7'd37: step=32'd6095311;
7'd38: step=32'd6457757;
7'd39: step=32'd6841755;
7'd40: step=32'd7248587;
7'd41: step=32'd7679610;
7'd42: step=32'd8136263;
7'd43: step=32'd8620071;
7'd44: step=32'd9132647;
7'd45: step=32'd9675702;
7'd46: step=32'd10251050;
7'd47: step=32'd10860609;
7'd48: step=32'd11506414;
7'd49: step=32'd12190621;
7'd50: step=32'd12915513;
7'd51: step=32'd13683509;
7'd52: step=32'd14497173;
7'd53: step=32'd15359220;
7'd54: step=32'd16272527;
7'd55: step=32'd17240142;
7'd56: step=32'd18265294;
7'd57: step=32'd19351405;
7'd58: step=32'd20502099;
7'd59: step=32'd21721217;
7'd60: step=32'd23012828;
7'd61: step=32'd24381242;
7'd62: step=32'd25831026;
7'd63: step=32'd27367019;
7'd64: step=32'd28994347;
7'd65: step=32'd30718440;
7'd66: step=32'd32545054;
7'd67: step=32'd34480283;
7'd68: step=32'd36530588;
7'd69: step=32'd38702809;
7'd70: step=32'd41004198;
7'd71: step=32'd43442435;
7'd72: step=32'd46025656;
7'd73: step=32'd48762484;
7'd74: step=32'd51662052;
7'd75: step=32'd54734038;
7'd76: step=32'd57988693;
7'd77: step=32'd61436880;
7'd78: step=32'd65090107;
7'd79: step=32'd68960566;
7'd80: step=32'd73061175;
7'd81: step=32'd77405619;
7'd82: step=32'd82008396;
7'd83: step=32'd86884869;
7'd84: step=32'd92051312;
7'd85: step=32'd97524968;
7'd86: step=32'd103324105;
7'd87: step=32'd109468076;
7'd88: step=32'd115977386;
7'd89: step=32'd122873760;
7'd90: step=32'd130180214;
7'd91: step=32'd137921133;
7'd92: step=32'd146122350;
7'd93: step=32'd154811237;
7'd94: step=32'd164016792;
7'd95: step=32'd173769738;
7'd96: step=32'd184102625;
7'd97: step=32'd195049936;
7'd98: step=32'd206648209;
7'd99: step=32'd218936151;
7'd100: step=32'd231954772;
7'd101: step=32'd245747521;
7'd102: step=32'd260360429;
7'd103: step=32'd275842266;
7'd104: step=32'd292244700;
7'd105: step=32'd309622474;
7'd106: step=32'd328033585;
7'd107: step=32'd347539477;
7'd108: step=32'd368205249;
7'd109: step=32'd390099873;
7'd110: step=32'd413296419;
7'd111: step=32'd437872302;
7'd112: step=32'd463909545;
7'd113: step=32'd491495042;
7'd114: step=32'd520720858;
7'd115: step=32'd551684531;
7'd116: step=32'd584489400;
7'd117: step=32'd619244949;
7'd118: step=32'd656067170;
7'd119: step=32'd695078954;
7'd120: step=32'd736410499;
7'd121: step=32'd780199746;
7'd122: step=32'd826592837;
7'd123: step=32'd875744605;
7'd124: step=32'd927819089;
7'd125: step=32'd982990083;
7'd126: step=32'd1041441715;
7'd127: step=32'd1103369062;
default: step=0;
endcase
endmodule
